TVavrinec/Jesper/MB12800/hardware/vysokonapetove_kondenzatory_JLCPCB.xlsx

keramika |  |  |  | elektrolit
oznaceni_JLCBPC | napeti | kapacita | proud | oznaceni_JLCBPC | napeti | kapacita
C13832 | 100V | 1.00µf |  | C311667 | 50V | 68.00µf
C307580 | 630V | 0.10µf | 50mA | C249459 | 100V | 10.00µf
C73745 | 250V | 0.10µf |  | C134777 | 100V | 47.00µf
C159756 | 200V | 0.10µf |  | C249458 | 100V | 10.00µf
 |  |  |  | C134747 | 100V | 10.00µf
 |  |  |  | C311614 | 63V | 22.00µf
 |  |  |  | C134831 | 80V | 47.00µf
 |  |  |  | C324061 | 100V | 22.00µf
 |  |  |  | C249468 | 63V | 100.00µf
 |  |  |  | C249491 | 100V | 22.00µf
 |  |  |  | C249576 | 100V | 10.00µf
 |  |  |  | C134817 | 100V | 22.00µf
 |  |  |  | C249899 | 100V | 33.00µf
 |  |  |  | C164068 | 100V | 47.00µf
 |  |  |  | C134748 | 100V | 10.00µf
