TVavrinec/Jesper/MB12800/hardware/kalkulacka_delice_ke_stabylizátoru.xlsx

 | r1 | r2
vstup | 127 | 100 | kΩ
vystup | korygovaný dělitel | 2.257124611
 | Vout | 2.742406402 | 2.798834517 | 2.855262633
