TVavrinec/Jesper/MB12800/hardware/seznam sistemu a vypočet napájecího proudu.xlsx

co | standard proud | maximální proud pro jeden kus [A] | kolikrát | maximum periperie | komplet standard | skok | napětí článku [V] | počet článku | napájecí napětí [V] | proud pro klasické srevo [A] | počet klasických serv | proud pro inteligentní srevo [A] | počet inteligentních serv | maximální výsledný proud pro celý systém [A] | standradní výsledný proud pro celý systém [A]
DRV8873 | 3 | 10 | 4 | 40 | 12 | 28 | 3.7 | 6 | 22.2 | 5 | 4 | 4 | 4 | 67.86974474 | 24.41126126
TCM2224 | 1.6 | 4 | 4 | 16 | 6.4 | 9.6
5V step down | 2.502502503 | 5.005005005 | 1 | 5.005005005 | 2.502502503 | 2.502502503
8V step down | 3.203203203 | 6.406406406 | 1 | 6.406406406 | 3.203203203 | 3.203203203
logika | 0.3055555556 | 0.4583333333 | 1 | 0.4583333333 | 0.3055555556 | 0.1527777778
 |  |  |  | 0 | 0 | 0
 |  |  |  | 0 | 0 | 0
 |  |  |  | 0 | 0 | 0
 |  |  |  | 0 | 0 | 0
 |  |  |  | 0 | 0 | 0
 |  |  |  | 0 | 0 | 0
 |  |  |  | 0 | 0 | 0
 |  |  |  | 0 | 0 | 0
 |  |  |  | 0 | 0 | 0
 |  |  |  | 0 | 0 | 0
 |  |  |  | 0 | 0 | 0
 |  |  |  | 0 | 0 | 0
 |  |  |  | 0 | 0 | 0
 |  |  |  | 0 | 0 | 0
 |  |  |  | 0 | 0 | 0
 |  |  |  | 0 | 0 | 0
 |  |  |  | 0 | 0 | 0
 |  |  |  | 0 | 0 | 0
 |  |  |  | 0 | 0 | 0
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
