TVavrinec/Jesper/RB3202S/hardware/V0.1/birokraccie/8067518513_awb51.pdf

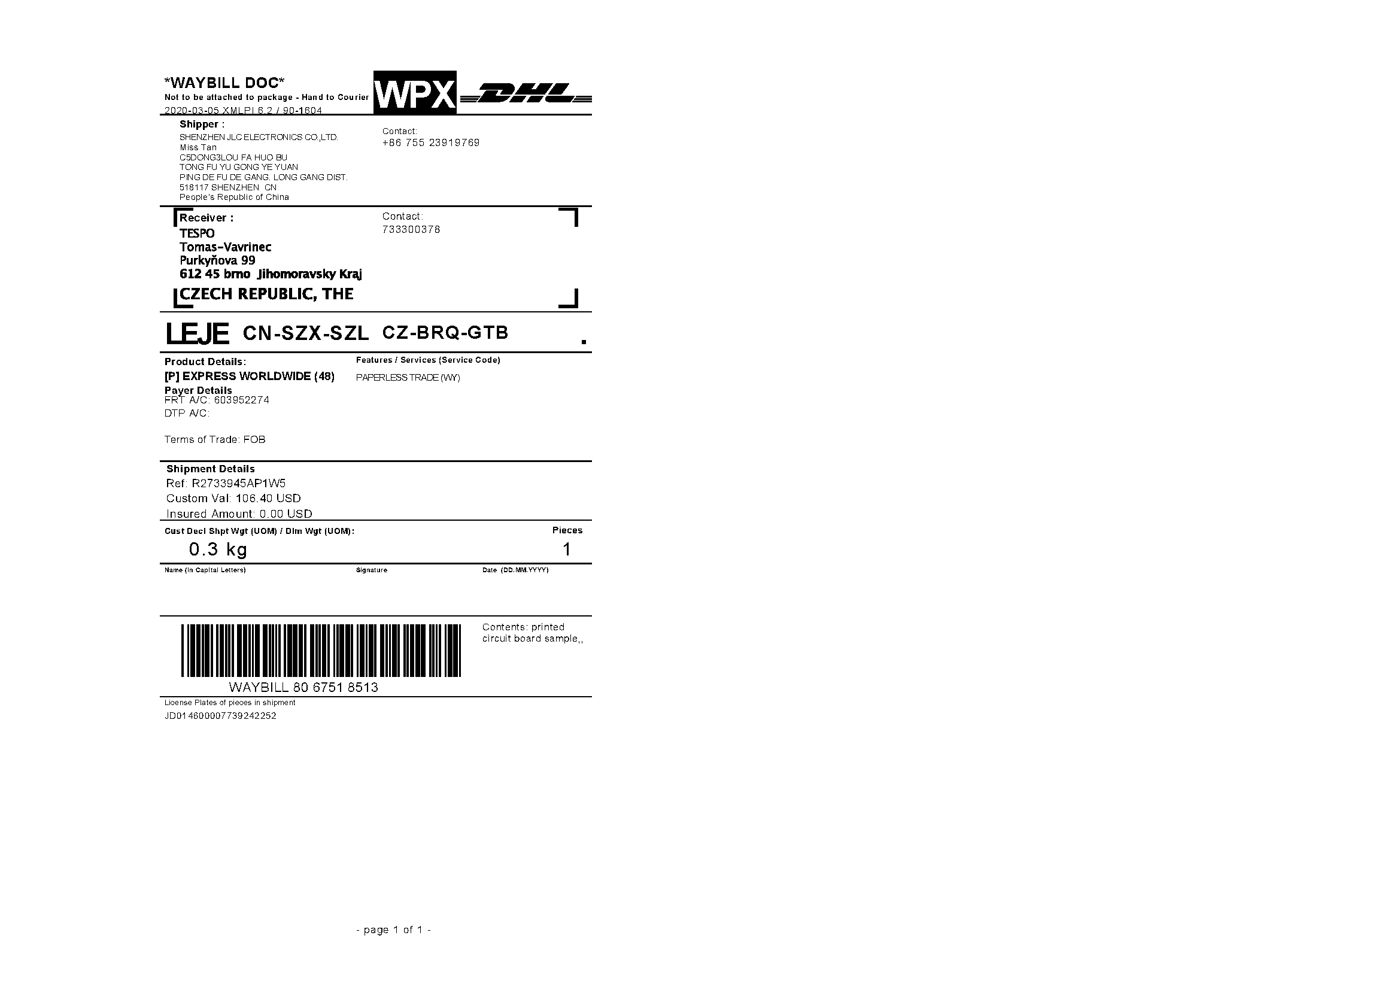
[picture p1: page 1]
