TVavrinec/Jesper/RB3202S/hardware/V0.1/birokraccie/8067518513_inv50.pdf

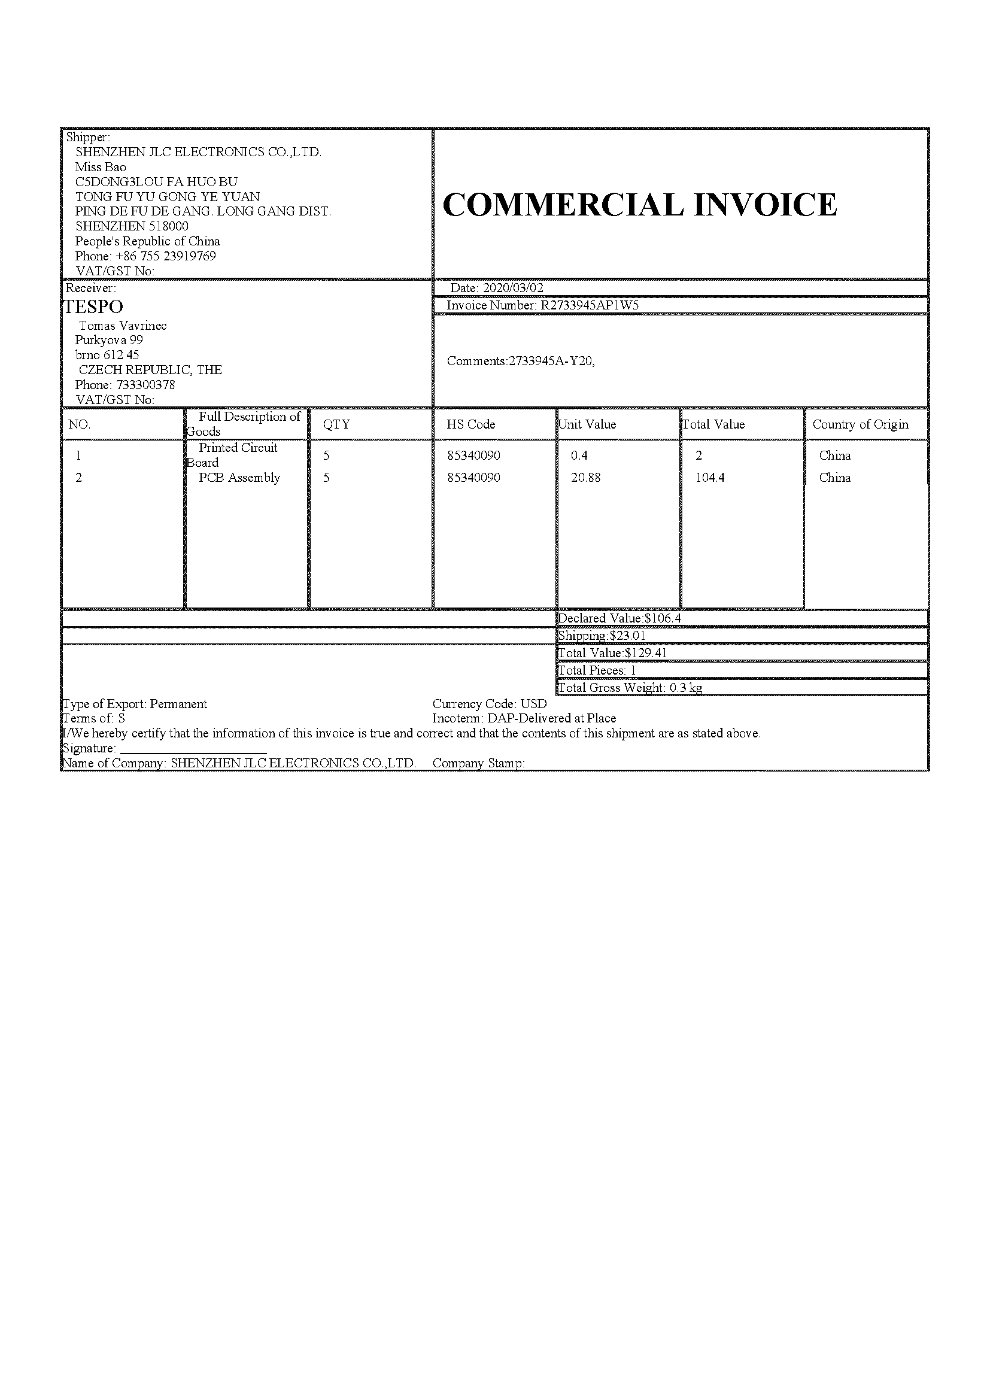
[picture p2: page 1]
