TVavrinec/Jesper/RB3202S/hardware/V0.2/123-removebg-preview.bmp

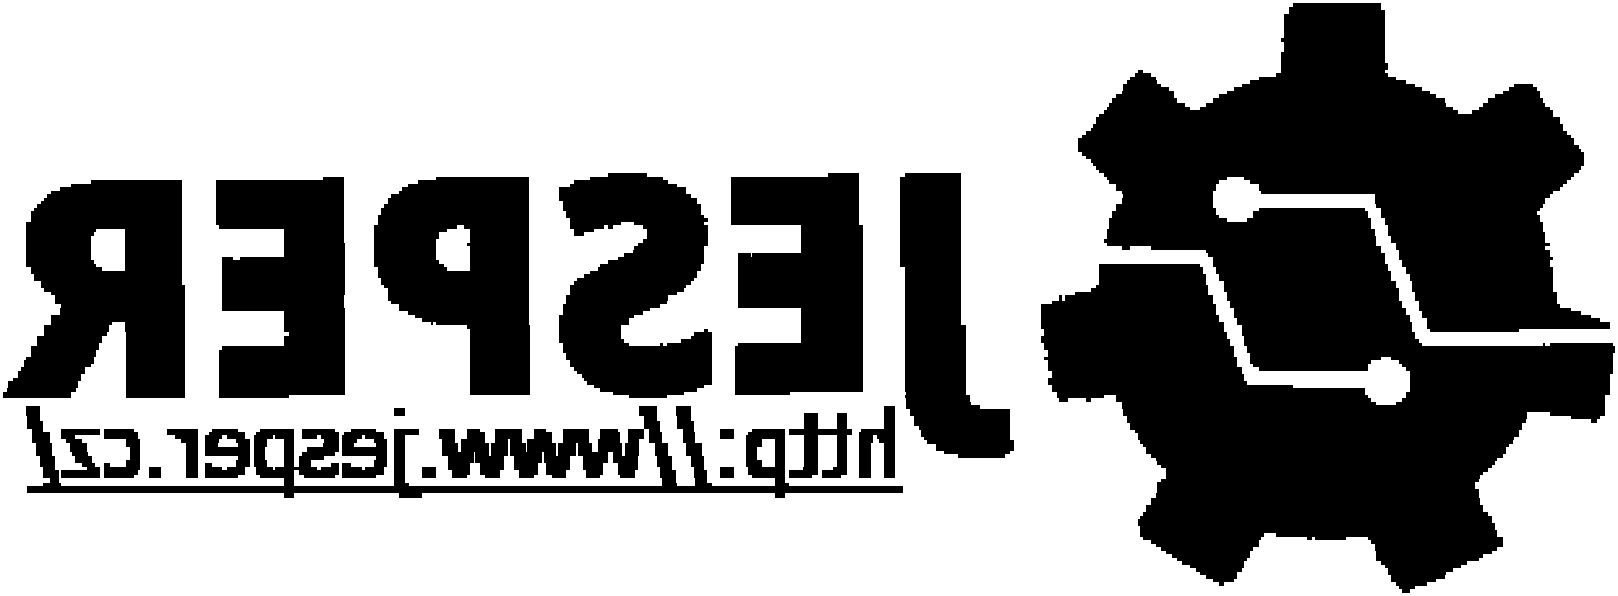
RB3202S/hardware/V0.2/123-removebg-preview.bmp
