TVavrinec/Jesper/RB3202S/navody/1/semafor na tlacitka.png

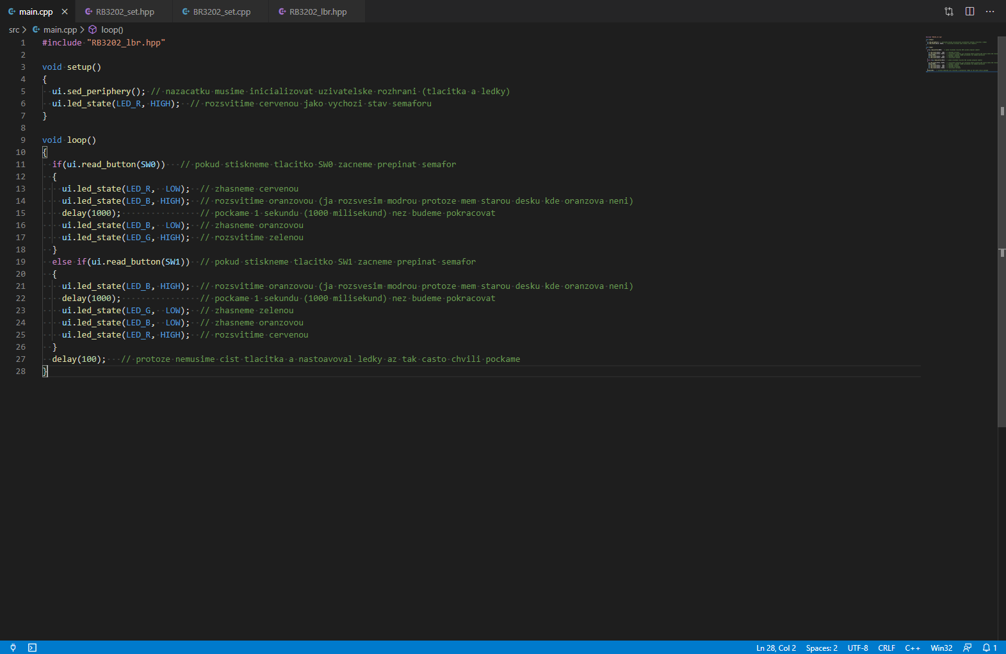
RB3202S/navody/1/semafor na tlacitka.png
