TVavrinec/Jesper/RB3202S/hardware/V0.2/gerber_file/BOM_RB3202S_V0.2.xlsx

Comment | Designator | Footprint | LCSC Part #（optional）
 | IC1, IC2 | SOT-233 | C134077
270uf | C6, C7 | SMD-ECAP-10x10 | C311624
100nf | C3, C4, C5, C8, C13, C14, C20, C21, C23 | 0402_C | C1525
10uf | C1, C2, C10, C11, C16, C17 | 1206_C | C89632 (https://lcsc.com/product-detail/Multilayer-Ceramic-Capacitors-MLCC-SMD-SMT_SAMSUNG_CL31B106KBHNNNE_10uF-106-10-50V_C89632.html/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)
10uf | C69, C70 | 0805_C | C15850
2.2uf | C9 | 0805_C | C49217 (https://lcsc.com/product-detail/Multilayer-Ceramic-Capacitors-MLCC-SMD-SMT_2-2uF-225-20-50V_C49217.html/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)
2.2nf | C12 | 0402_C | C1531
100nf | C18 | 1206_C | C24497
10nf | C15 | 0402_C | C15195
 | D1 | SMB,DO-214AA | C97318
 | D2 | SOD-323 | C8486 (https://lcsc.com/product-detail/Schottky-Barrier-Diodes-SBD_Changjiang-Electronics-Tech-CJ-1SS357_C8486.html/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)
 | LED0, LED4 | LED_0603 | C2286
 | LED2, LED3 | LED_0603 | C72043
 | LED1 | LED_0603 | C72038
 | SW0, SW1, SW2, SW3, ON, BOOT | SMD-SW-4_5.1x5.1x2.5 | C318887 (https://lcsc.com/product-detail/Tactile-Switches_XKB-Enterprise-TS-1187A-C-E-A_C318887.html/?href=jlc-SMT)
 | Q1, Q3 | DFN-8_EP_5.2x6.0x1.27P | C377869
 | Q2, Q4, Q5, Q6, Q7, Q10 | SOT-23-3 | C122850
 | U$9 | HTSSOP-16_EP_4.4x5.0x0.65P | C50506 (https://lcsc.com/product-detail/Motor-Drivers_TI_DRV8833PWP_DRV8833PWP_C50506.html/?href=jlc-SMT)
 | U1 | QFN-24_EP_4.0x4.0x0.5P | C24112
1M | R1, R4 | 0402_R | C26083
10k | R2, R6, R7, R8, R9, R10, R12, R20, R22, R23, R51 | 0402_R | C25744
100k | R3, R52 | 0402_R | C25741
100k | R5 | 0402_R | C25741 (https://lcsc.com/product-detail/Chip-Resistor-Surface-Mount_Uniroyal-Elec-0402WGF1003TCE_C25741.html/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)
30k | R11 | 0402_R | C105614 (https://lcsc.com/product-detail/High-Precision-Low-TCR-SMD-Resistors_Uniroyal-Elec-TC0225B3002TCE_C105614.html/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)
30k | R21 | 0402_R | C105614
30k | R49, R50 | 0402_R | C105614 (https://lcsc.com/product-detail/High-Precision-Low-TCR-SMD-Resistors_Uniroyal-Elec-TC0225B3002TCE_C105614.html/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)
120 | R48 | 0402_R | C25079 (https://lcsc.com/product-detail/Chip-Resistor-Surface-Mount_Uniroyal-Elec-0402WGF1200TCE_C25079.html/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)
220 | R13-19 | 0402_R | C25092
 | MAX1 | SOIC-8_3.9x4.9x1.27P | C23492 (https://lcsc.com/product-detail/RS-485-RS-422_MAXIM_MAX485EESA-T_MAX485EESA-T_C23492.html/?href=jlc-SMT)
