TVavrinec/Jesper/RB3202S/hardware/RB3202S.brd

## EAGLE design RB3202S/hardware/RB3202S.brd (2020-05-02)

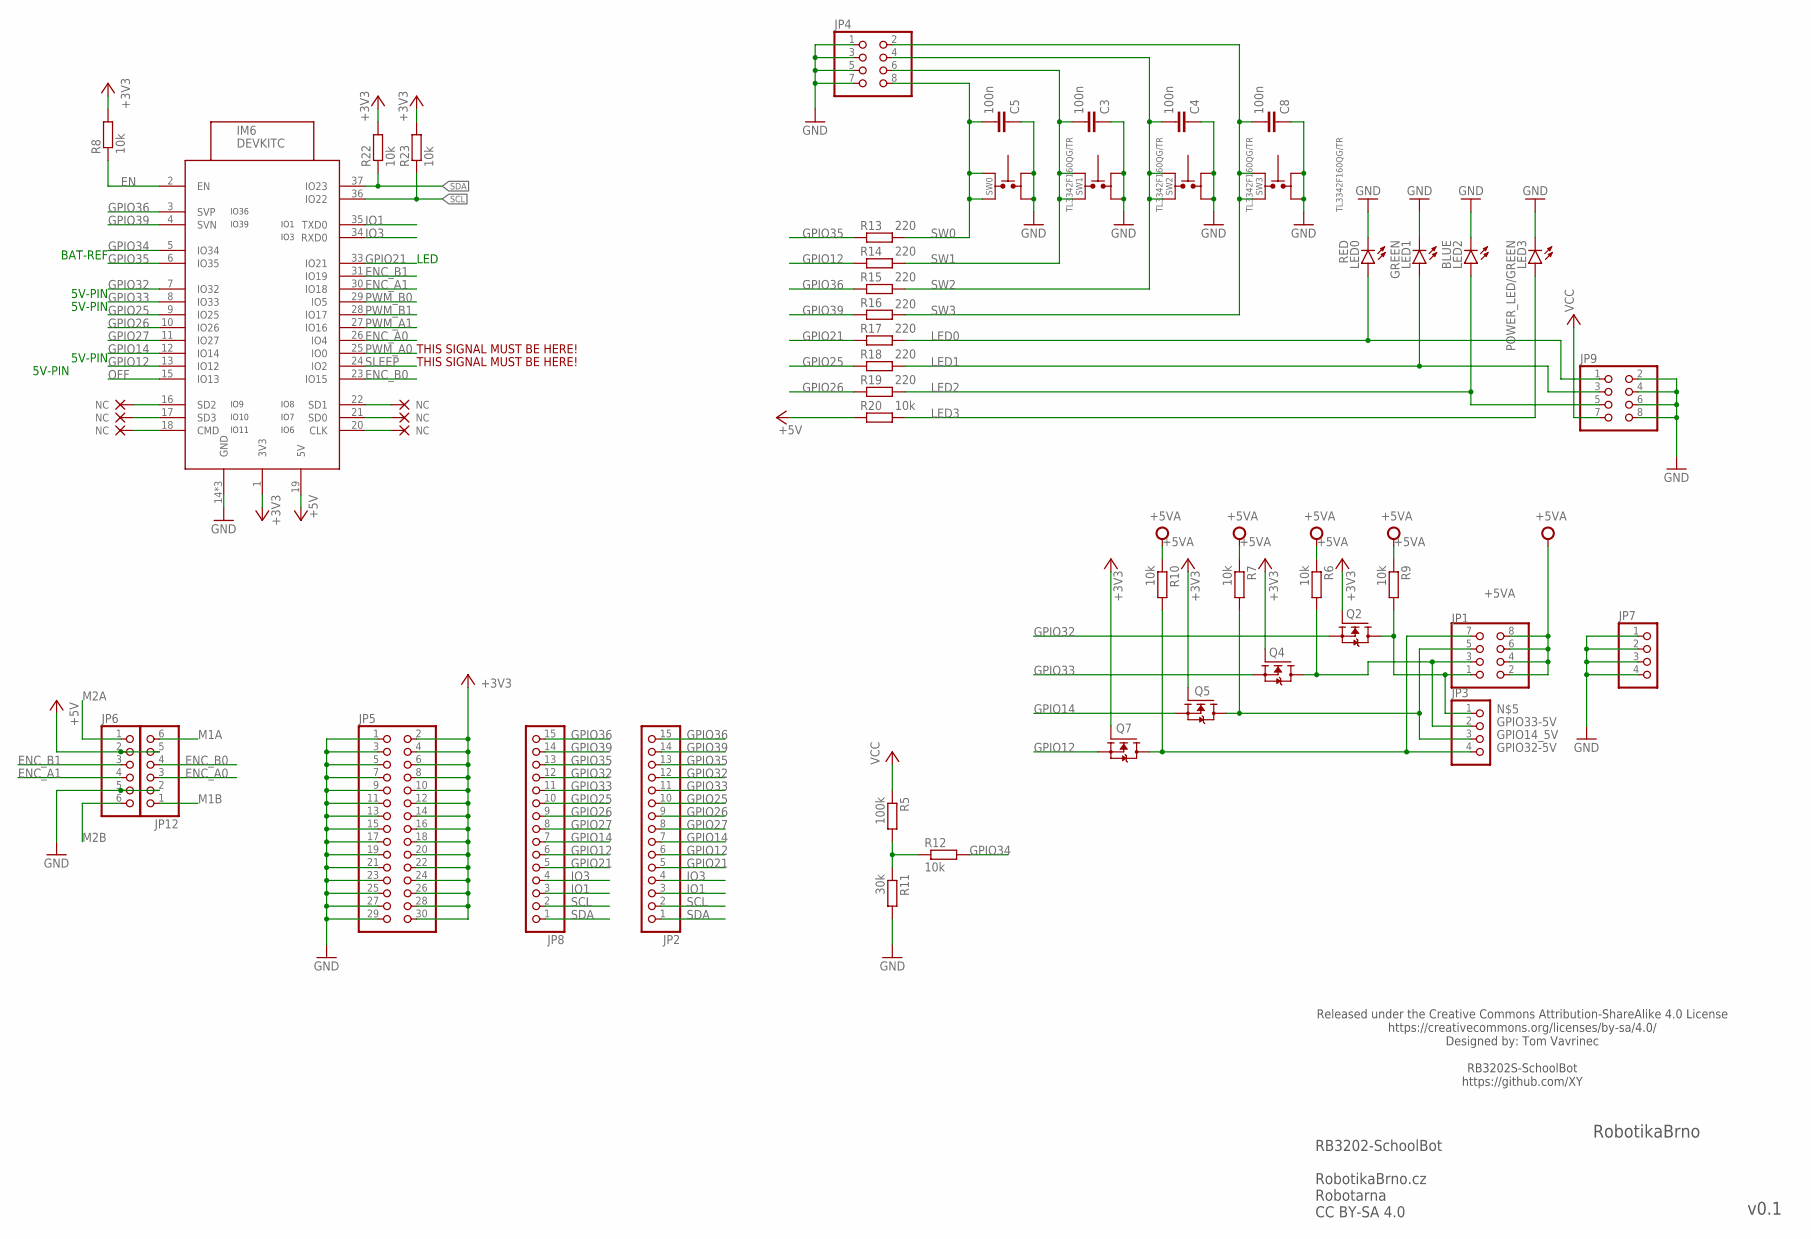
[picture p5: schematic RB3202S.sch, sheet 1]

Parts:
C3, C4, C5, C8: 100n; C0402
IM6: DEVKITC
JP1, JP4, JP9: PINHD-2X4; 2X04
JP2, JP8: PINHD-1X15; 1X15
JP3, JP7: PINHD-1X4; 1X04
JP5: PINHD-2X15; 2X15
JP6, JP12: PINHD-1X6; 1X06
LED0: RED; SML0603
LED1: GREEN; SML0603
LED2: BLUE; SML0603
LED3: POWER_LED/GREEN; SML0603
Q2, Q4, Q5, Q7: N-MOSFET-SOT23-GSD; SOT23
R5: 100k; R0402
R6, R7, R8, R9, R10, R12, R20, R22, R23: 10k; R0402
R11: 30k; R0402
R13, R14, R15, R16, R17, R18, R19: 220; R0402
SW0, SW1, SW2, SW3: TL3342F160QG/TR

Connections:
+3V3: IM6.1 (3V3), JP5.2, JP5.4, JP5.6, JP5.8, JP5.10, JP5.12, JP5.14, JP5.16, JP5.18, JP5.20, JP5.22, JP5.24, JP5.26, JP5.28, JP5.30, Q2.1 (G), Q4.1 (G), Q5.1 (G), Q7.1 (G), R8.2, R22.2, R23.2; also elsewhere on the board
+5V: IM6.19 (5V), JP6.2, JP12.5, R20.1; also elsewhere on the board
+5VA: JP1.2, JP1.4, JP1.6, JP1.8, R6.1, R7.1, R9.1, R10.1; also elsewhere on the board
EN: IM6.2 (EN), R8.1; also elsewhere on the board
ENC_A0: IM6.26 (IO4), JP12.3
ENC_A1: IM6.30 (IO18), JP6.4
ENC_B0: IM6.23 (IO15), JP12.4
ENC_B1: IM6.31 (IO19), JP6.3
GND: C3.1, C4.1, C5.1, C8.1, IM6.14 (GND), IM6.32 (GND), IM6.38 (GND), JP4.1, JP4.3, JP4.5, JP4.7, JP5.1, JP5.3, JP5.5, JP5.7, JP5.9, JP5.11, JP5.13, JP5.15, JP5.17, JP5.19, JP5.21, JP5.23, JP5.25, JP5.27, JP5.29, JP6.5, JP7.1, JP7.2, JP7.3, JP7.4, JP9.2, JP9.4, JP9.6, JP9.8, JP12.2, LED0.C, LED1.C, LED2.C, LED3.C, R11.2, SW0.1, SW0.2, SW1.1, SW1.2, SW2.1, SW2.2, SW3.1, SW3.2; also elsewhere on the board
GPIO12: IM6.13 (IO12), JP2.6, JP8.6, Q7.2 (S), R14.1
GPIO14: IM6.12 (IO14), JP2.7, JP8.7, Q5.2 (S)
GPIO14_5V: JP1.5, JP3.3, Q5.3 (D), R7.2
GPIO21: IM6.33 (IO21), JP2.5, JP8.5, R17.1; also elsewhere on the board
GPIO25: IM6.9 (IO25), JP2.10, JP8.10, R18.1
GPIO26: IM6.10 (IO26), JP2.9, JP8.9, R19.1
GPIO27: IM6.11 (IO27), JP2.8, JP8.8; also elsewhere on the board
GPIO32: IM6.7 (IO32), JP2.12, JP8.12, Q2.2 (S)
GPIO32-5V: JP1.7, JP3.4, Q7.3 (D), R10.2
GPIO33: IM6.8 (IO33), JP2.11, JP8.11, Q4.2 (S)
GPIO33-5V: JP1.3, JP3.2, Q4.3 (D), R6.2
GPIO34: IM6.5 (IO34), R12.2
GPIO35: IM6.6 (IO35), JP2.13, JP8.13, R13.1
GPIO36: IM6.3 (SVP), JP2.15, JP8.15, R15.1; also elsewhere on the board
GPIO39: IM6.4 (SVN), JP2.14, JP8.14, R16.1; also elsewhere on the board
IO1: IM6.35 (TXD0), JP2.3, JP8.3
IO3: IM6.34 (RXD0), JP2.4, JP8.4
IO9_NC: IM6.16 (SD2)
IO9_NC1: IM6.20 (CLK)
IO10_NC: IM6.17 (SD3)
IO10_NC1: IM6.21 (SD0)
IO11_NC: IM6.18 (CMD)
IO11_NC1: IM6.22 (SD1)
LED0: JP9.1, LED0.A, R17.2
LED1: JP9.3, LED1.A, R18.2
LED2: JP9.5, LED2.A, R19.2
LED3: LED3.A, R20.2
M1A: JP12.6; also elsewhere on the board
M1B: JP12.1; also elsewhere on the board
M2A: JP6.1; also elsewhere on the board
M2B: JP6.6; also elsewhere on the board
unnamed: R5.2, R11.1, R12.1
unnamed: JP1.1, JP3.1, Q2.3 (D), R9.2
OFF: IM6.15 (IO13); also elsewhere on the board
PWM_A0: IM6.25 (IO0); also elsewhere on the board
PWM_A1: IM6.27 (IO16); also elsewhere on the board
PWM_B0: IM6.29 (IO5); also elsewhere on the board
PWM_B1: IM6.28 (IO17); also elsewhere on the board
SCL: IM6.36 (IO22), JP2.2, JP8.2, R23.1; also elsewhere on the board
SDA: IM6.37 (IO23), JP2.1, JP8.1, R22.1; also elsewhere on the board
SLEEP: IM6.24 (IO2); also elsewhere on the board
SW0: C5.2, JP4.8, R13.2, SW0.3, SW0.4
SW1: C3.2, JP4.6, R14.2, SW1.3, SW1.4
SW2: C4.2, JP4.4, R15.2, SW2.3, SW2.4
SW3: C8.2, JP4.2, R16.2, SW3.3, SW3.4
VCC: JP9.7, R5.1; also elsewhere on the board

Notes on the sheet:
RB3202-SchoolBot RobotikaBrno.cz Robotarna CC BY-SA 4.0
RobotikaBrno
v0.1
Released under the Creative Commons Attribution-ShareAlike 4.0 License https://creativecommons.org/licenses/by-sa/4.0/ Designed by: Tom Vavrinec RB3202S-SchoolBot https://github.com/XY
THIS SIGNAL MUST BE HERE!
LED
5V-PIN
BAT-REF

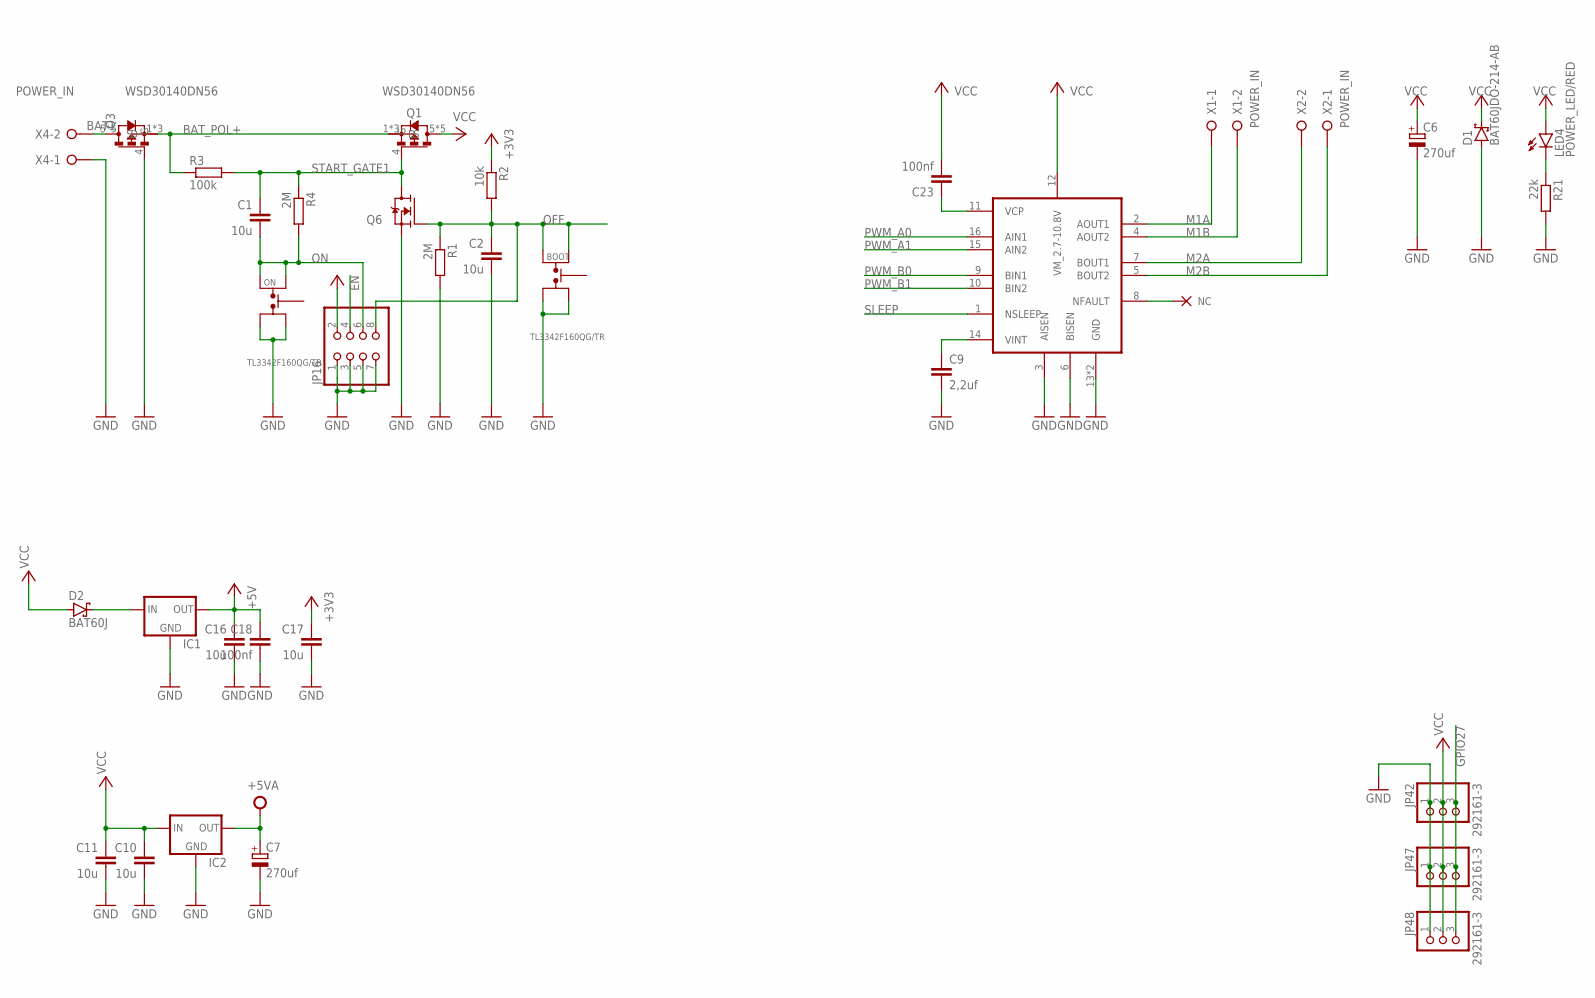
[picture p6: schematic RB3202S.sch, sheet 2]

Parts:
BOOT: TL3342F160QG/TR
C1, C2, C10, C11, C16, C17: 10u; C1206
C6, C7: 270uf; 140CLH-1010
C9: 2,2uf; C0805
C18: 100nf; C1206
C23: 100nf; C0402
D1: BAT60JDO-214-AB; DO214BA
D2: BAT60J; SOD323_ST
IC1, IC2: LM1117; SOT223
JP16: PINHD-2X4; 2X04
JP42, JP47, JP48: 292161-3
LED4: POWER_LED/RED; SML0603
ON: TL3342F160QG/TR
Q1, Q3: WSD30140DN56; DFN-8_EP_5.2X6.0X1.27P
Q6: N-MOSFET-SOT23-GSD; SOT23
R1, R4: 2M; R0402
R2: 10k; R0402
R3: 100k; R0402
R21: 22k; R0402
U$9: DRV8833CPWPR; SOP65P640X120-17N
X1, X2, X4: POWER_IN; W237-132

Connections:
+3V3: C17.1, R2.1; also elsewhere on the board
+5V: C16.1, C18.1, IC1.2 (OUT), IC1.4 (OUT), JP16.2; also elsewhere on the board
+5VA: C7.+, IC2.2 (OUT), IC2.4 (OUT); also elsewhere on the board
BAT1: Q3.5 (D), Q3.6 (D), Q3.7 (D), Q3.8 (D), Q3.9 (D), X4.2
BAT_POL+: Q1.1 (S), Q1.2 (S), Q1.3 (S), Q3.1 (S), Q3.2 (S), Q3.3 (S), R3.1
EN: JP16.4; also elsewhere on the board
GND: BOOT.1, BOOT.2, C2.2, C6.-, C7.-, C9.2, C10.2, C11.2, C16.2, C17.2, C18.2, D1.A, IC1.1 (GND), IC2.1 (GND), JP16.1, JP16.3, JP16.5, JP16.7, JP42.1, JP47.1, JP48.1, ON.1, ON.2, Q3.4 (G), Q6.2 (S), R1.2, R21.2, U$9.3 (AISEN), U$9.6 (BISEN), U$9.13 (GND), U$9.17 (GND), X4.1; also elsewhere on the board
GPIO27: JP42.3, JP47.3, JP48.3; also elsewhere on the board
IO9_NC2: U$9.8 (NFAULT)
M1A: U$9.2 (AOUT1), X1.1; also elsewhere on the board
M1B: U$9.4 (AOUT2), X1.2; also elsewhere on the board
M2A: U$9.7 (BOUT1), X2.2; also elsewhere on the board
M2B: U$9.5 (BOUT2), X2.1; also elsewhere on the board
unnamed: LED4.C, R21.1
unnamed: D2.C, IC1.3 (IN)
unnamed: C9.1, U$9.14 (VINT)
unnamed: C23.1, U$9.11 (VCP)
OFF: BOOT.3, BOOT.4, C2.1, JP16.8, Q6.1 (G), R1.1, R2.2; also elsewhere on the board
ON: C1.2, JP16.6, ON.3, ON.4, R4.2
PWM_A0: U$9.16 (AIN1); also elsewhere on the board
PWM_A1: U$9.15 (AIN2); also elsewhere on the board
PWM_B0: U$9.9 (BIN1); also elsewhere on the board
PWM_B1: U$9.10 (BIN2); also elsewhere on the board
SLEEP: U$9.1 (NSLEEP); also elsewhere on the board
START_GATE1: C1.1, Q1.4 (G), Q6.3 (D), R3.2, R4.1
VCC: C6.+, C10.1, C11.1, C23.2, D1.C, D2.A, IC2.3 (IN), JP42.2, JP47.2, JP48.2, LED4.A, Q1.5 (D), Q1.6 (D), Q1.7 (D), Q1.8 (D), Q1.9 (D), U$9.12 (VM_2.7-10.8V); also elsewhere on the board

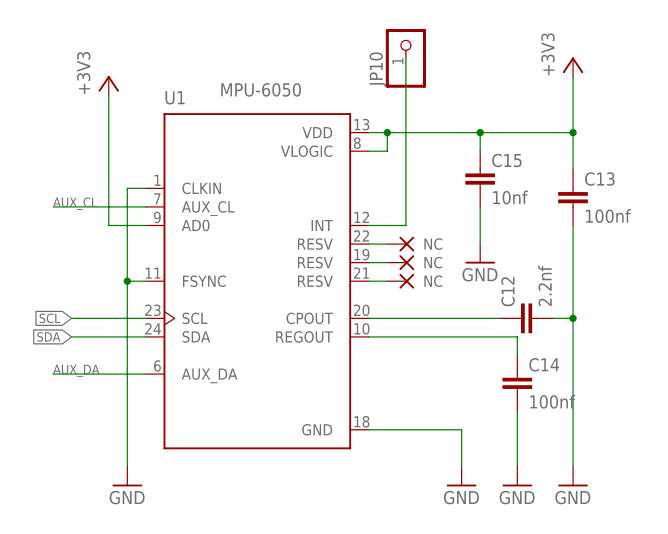
[picture p7: schematic RB3202S.sch, sheet 3]

Parts:
C12: 2.2nf; C0402
C13: 100nf; C0402
C14: 100nf; C0402P
C15: 10nf; C0402
JP10: PINHD-1X1; 1X01
U1: MPU-6050; QFN50P400X400X95-24N

Connections:
+3V3: C13.1, C15.1, U1.8 (VLOGIC), U1.9 (AD0), U1.13 (VDD); also elsewhere on the board
AUX_CL: U1.7 (AUX_CL)
AUX_DA: U1.6 (AUX_DA)
GND: C12.2, C13.2, C14.2, C15.2, U1.1 (CLKIN), U1.11 (FSYNC), U1.18 (GND); also elsewhere on the board
INT_MPU5060: JP10.1, U1.12 (INT)
IO9_NC4: U1.19 (RESV)
IO9_NC5: U1.21 (RESV)
IO10_NC4: U1.22 (RESV)
unnamed: C12.1, U1.20 (CPOUT)
unnamed: C14.1, U1.10 (REGOUT)
SCL: U1.23 (SCL); also elsewhere on the board
SDA: U1.24 (SDA); also elsewhere on the board

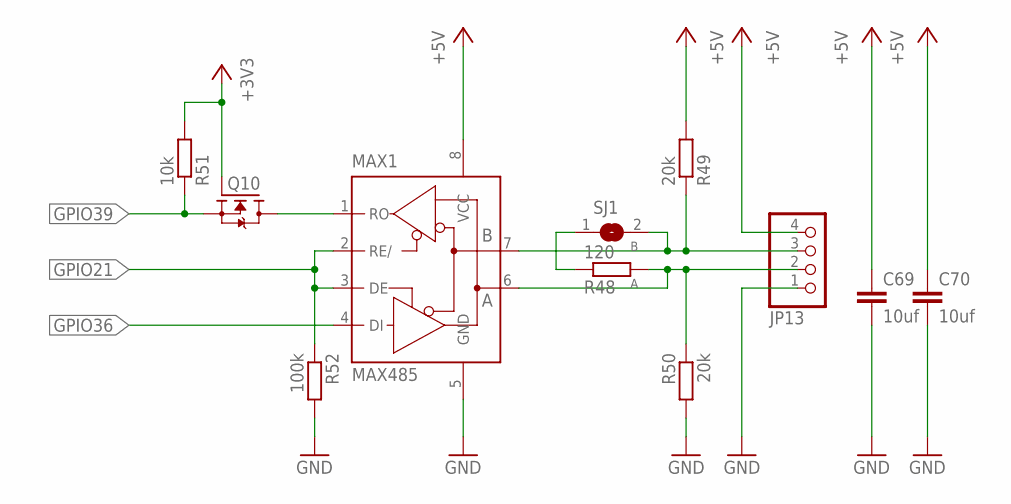
[picture p8: schematic RB3202S.sch, sheet 4]

Parts:
C69, C70: 10uf; C0805
JP13: PINHD-1X4; 1X04
MAX1: MAX485; SO08
Q10: N-MOSFET-SOT23-GSD; SOT23
R48: 120; R0402
R49, R50: 20k; R0402
R51: 10k; R0402
R52: 100k; R0402
SJ1: SJ

Connections:
+3V3: Q10.1 (G), R51.2; also elsewhere on the board
+5V: C69.1, C70.1, JP13.4, MAX1.8 (VCC), R49.2; also elsewhere on the board
A: JP13.2, MAX1.6 (A), R48.2, R50.1
B: JP13.3, MAX1.7 (B), R49.1, SJ1.2
GND: C69.2, C70.2, JP13.1, MAX1.5 (GND), R50.2, R52.2; also elsewhere on the board
GPIO21: MAX1.2 (RE/), MAX1.3 (DE), R52.1; also elsewhere on the board
GPIO36: MAX1.4 (DI); also elsewhere on the board
GPIO39: Q10.2 (S), R51.1; also elsewhere on the board
unnamed: R48.1, SJ1.1
RX-485-5V: MAX1.1 (RO), Q10.3 (D)

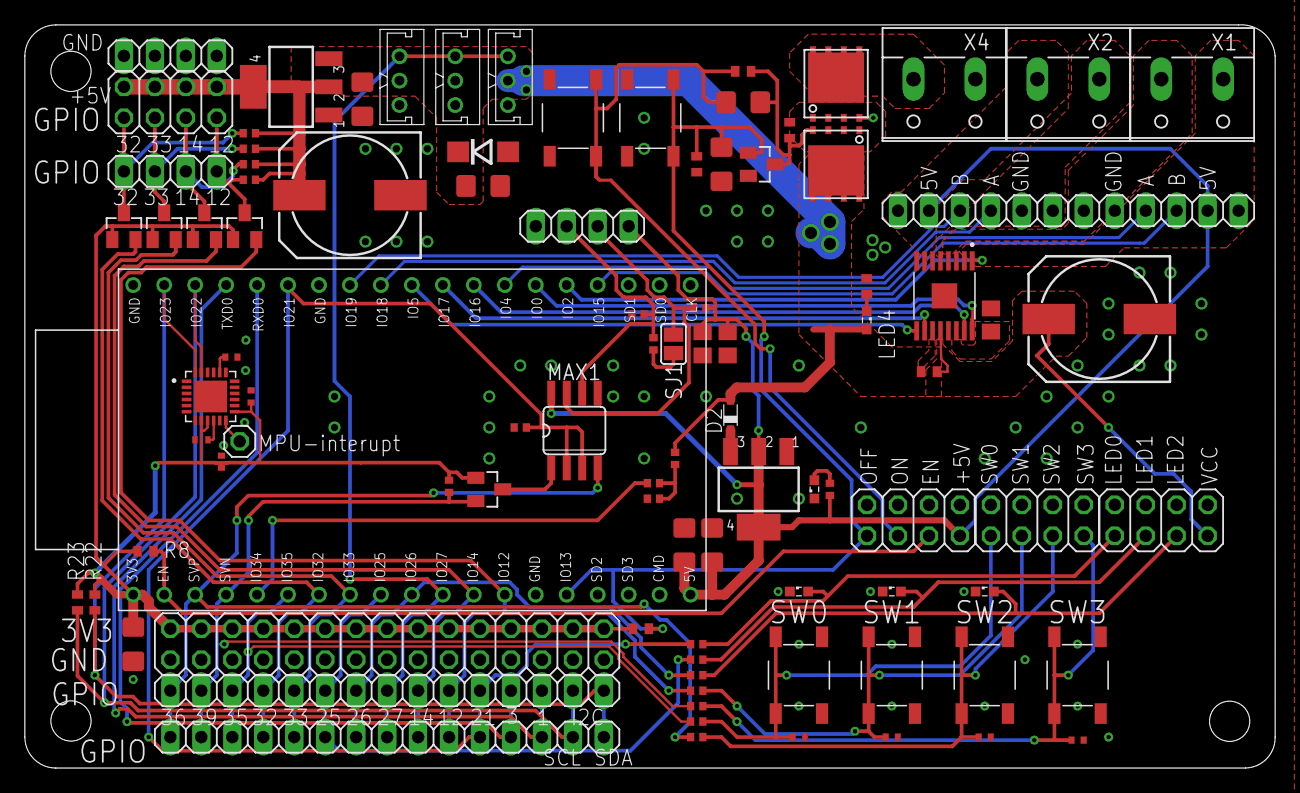
[picture p9: board RB3202S.brd from above]

Board: 2 copper layers, 102.6 x 61.0 mm, 96 parts (0 on the bottom side), 64 nets.
