TVavrinec/Jesper/UI01/untitled.brd

## EAGLE design UI01/untitled.brd (2020-02-24)

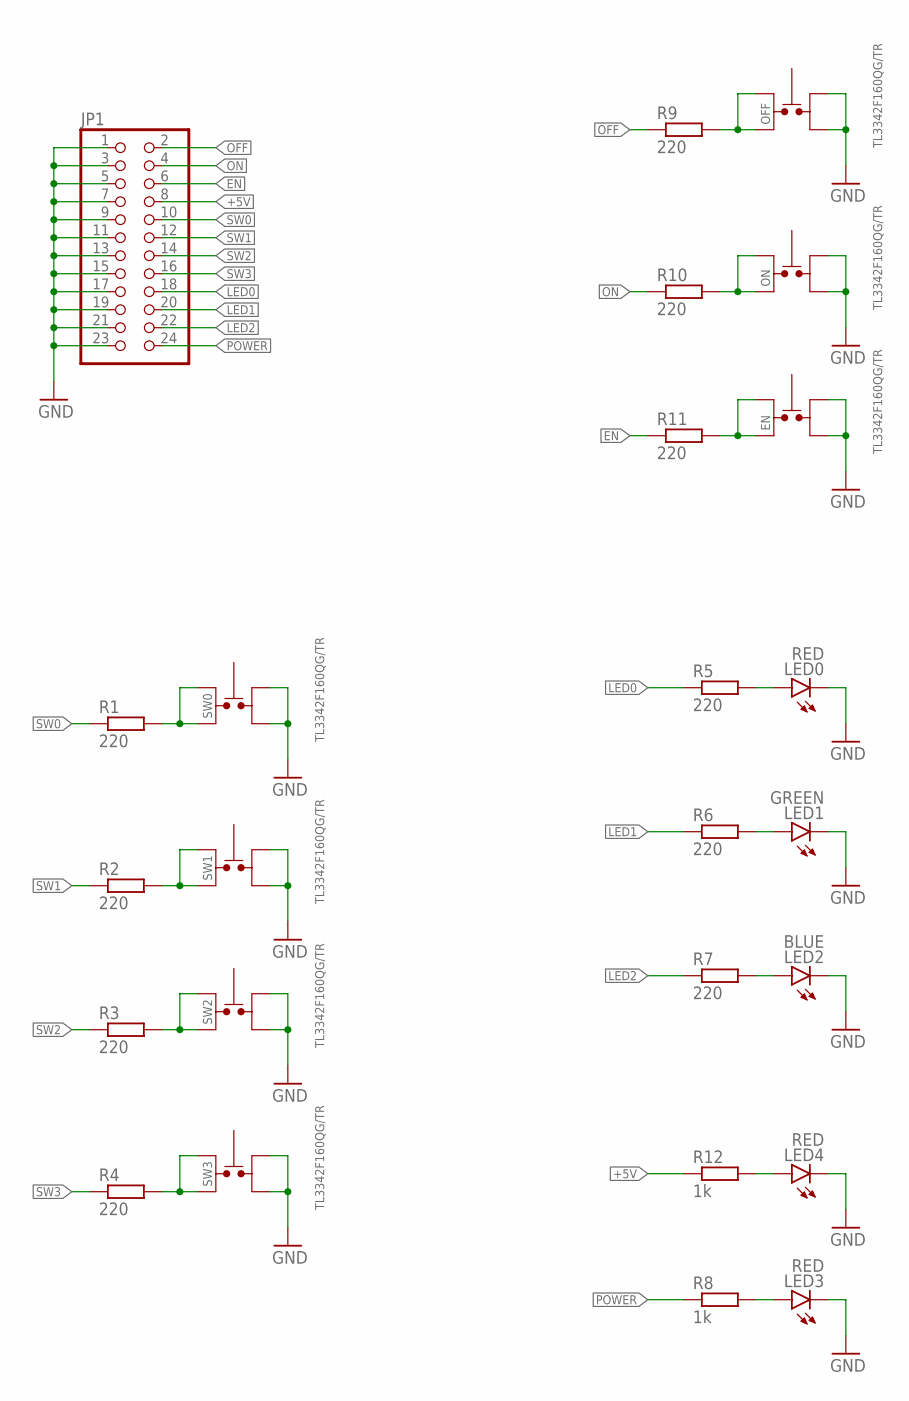
[picture p10: schematic untitled.sch]

Parts:
EN: TL3342F160QG/TR
JP1: PINHD-2X12; 2X12
LED0, LED3, LED4: RED; SML0603
LED1: GREEN; SML0603
LED2: BLUE; SML0603
OFF: TL3342F160QG/TR
ON: TL3342F160QG/TR
R1, R2, R3, R4, R5, R6, R7, R9, R10, R11: 220; R0402
R8, R12: 1k; R0402
SW0, SW1, SW2, SW3: TL3342F160QG/TR

Connections:
+5V: JP1.8, R12.1
EN: JP1.6, R11.1
GND: EN.1, EN.2, JP1.1, JP1.3, JP1.5, JP1.7, JP1.9, JP1.11, JP1.13, JP1.15, JP1.17, JP1.19, JP1.21, JP1.23, LED0.C, LED1.C, LED2.C, LED3.C, LED4.C, OFF.1, OFF.2, ON.1, ON.2, SW0.1, SW0.2, SW1.1, SW1.2, SW2.1, SW2.2, SW3.1, SW3.2
LED0: JP1.18, R5.1
LED1: JP1.20, R6.1
LED2: JP1.22, R7.1
unnamed: R1.2, SW0.3, SW0.4
unnamed: R2.2, SW1.3, SW1.4
unnamed: R3.2, SW2.3, SW2.4
unnamed: R4.2, SW3.3, SW3.4
unnamed: LED0.A, R5.2
unnamed: LED1.A, R6.2
unnamed: LED2.A, R7.2
unnamed: LED3.A, R8.2
unnamed: OFF.3, OFF.4, R9.2
unnamed: ON.3, ON.4, R10.2
unnamed: EN.3, EN.4, R11.2
unnamed: LED4.A, R12.2
OFF: JP1.2, R9.1
ON: JP1.4, R10.1
POWER: JP1.24, R8.1
SW0: JP1.10, R1.1
SW1: JP1.12, R2.1
SW2: JP1.14, R3.1
SW3: JP1.16, R4.1

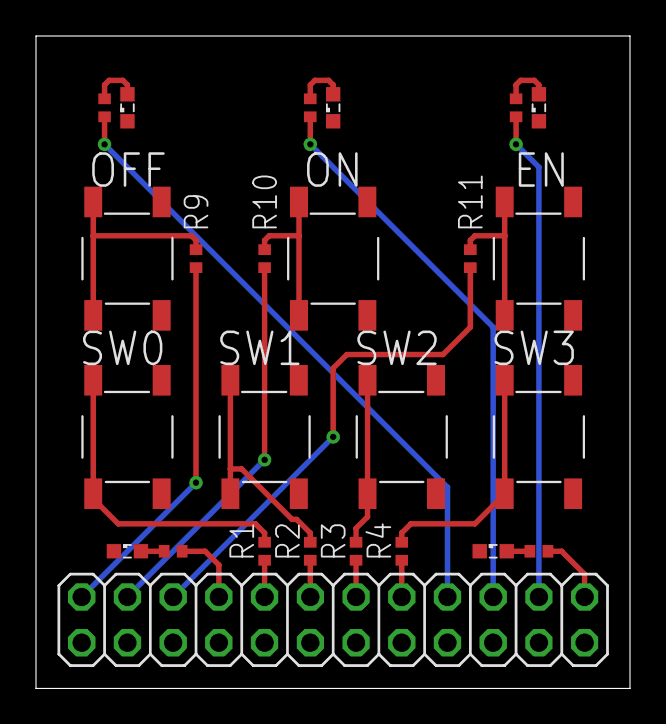
[picture p11: board untitled.brd from above]

Board: 2 copper layers, 33.0 x 36.2 mm, 25 parts (0 on the bottom side), 25 nets.
