TVavrinec/Jesper/RB3202S/program_lbr/src/RB3202_encoder.cpp

#include <stdio.h>
#include "freertos/FreeRTOS.h"
#include "freertos/portmacro.h"
#include "freertos/task.h"
#include "freertos/queue.h"
#include "driver/periph_ctrl.h"
#include "driver/gpio.h"
#include "driver/pcnt.h"
#include "esp_attr.h"
#include "esp_log.h"
#include "soc/gpio_sig_map.h"
//#include "esp32-hal-adc.h"
#include "esp_system.h"
#include "RB3202_encoder.hpp"

uint64_t RB3202_encoder::gpioInputPinSel = 1;
uint8_t RB3202_encoder::nextCounterIndex = 0;

void IRAM_ATTR RB3202_encoder::gpio_isr_handler(void* arg) 
{
    //Handle edge interrupt time for frequency calculation
    int64_t currentTime = esp_timer_get_time();
    struct CounterTimeData * aCounterTimeData = (struct CounterTimeData *)arg;
    if(currentTime > aCounterTimeData->counterPrevTime + aCounterTimeData->debounceUs) 
    {
        aCounterTimeData->counterTimeDiff = currentTime - aCounterTimeData->counterPrevTime;
        if(gpio_get_level(static_cast<gpio_num_t>(pcntPins[2*(aCounterTimeData->aCounterIndex) + 1])))
            aCounterTimeData->counterTimeDiff = -aCounterTimeData->counterTimeDiff;
        aCounterTimeData->counterPrevTime = currentTime;
    }
    //TODO - Handle possible PCNT overflow interrupt...
}

RB3202_encoder::RB3202_encoder(uint8_t aGpioA, uint8_t aGpioB) 
{
    
    counterIndex = nextCounterIndex++;
    if(counterIndex > 7) {  //Out of PCNT units
        return;
    }
    gpioA = aGpioA;
    gpioB = aGpioB;
    for(uint8_t i = 0; i < 16; ++i) 
    {
        if(gpioA == pcntPins[i] )
            break;
        if(i == 15) 
        {   //Not a PCNT enabled pin selected first
            return;
        }
    }
}

void RB3202_encoder::init() {
    pcnt_ctrl_mode_t lctrl_mode = reverse ? PCNT_MODE_REVERSE : PCNT_MODE_KEEP;
    pcnt_ctrl_mode_t hctrl_mode = reverse ? PCNT_MODE_KEEP : PCNT_MODE_REVERSE;
    pcnt_count_mode_t pos_mode = risingSensitive ? PCNT_COUNT_INC : PCNT_COUNT_DIS;
    pcnt_count_mode_t neg_mode = fallingSensitive ? PCNT_COUNT_DEC : PCNT_COUNT_DIS;

    //Initialize PCNT functions
    pcnt_config_t pcnt_config = 
    {
        // Set PCNT input signal and control GPIOs
        gpioA,   //pulse_gpio_num
        gpioB,    //ctrl_gpio_num
        // What to do when control input is low or high?
        lctrl_mode,   //lctrl_mode  // Keep the primary counter mode if high
        hctrl_mode,  //hctrl_mode   // Reverse counting direction if low
        // What to do on the positive / negative edge of pulse input?
        pos_mode, //pos_mode   // Count up on the positive edge
        neg_mode, //neg_mode   // Keep the counter value on the negative edge
        // Set the maximum and minimum limit values to watch
        PCNT_H_LIM_VAL, //counter_h_lim
        PCNT_L_LIM_VAL, //counter_l_lim
        pcnt_unit_t(counterIndex),   //unit
        PCNT_CHANNEL_0, //channel
    };
    pcnt_unit_config(&pcnt_config); //Initialize PCNT units

    /* Configure and enable the input filter */
    pcnt_set_filter_value(pcnt_unit_t(counterIndex), 255);
    pcnt_filter_enable(pcnt_unit_t(counterIndex));

    /* Set threshold 0 and 1 values and enable events to watch */
    pcnt_set_event_value(pcnt_unit_t(counterIndex), PCNT_EVT_THRES_1, PCNT_THRESH1_VAL);
    pcnt_event_enable(pcnt_unit_t(counterIndex), PCNT_EVT_THRES_1);
    pcnt_set_event_value(pcnt_unit_t(counterIndex), PCNT_EVT_THRES_0, PCNT_THRESH0_VAL);
    pcnt_event_enable(pcnt_unit_t(counterIndex), PCNT_EVT_THRES_0);
    /* Enable events on zero, maximum and minimum limit values */
    pcnt_event_enable(pcnt_unit_t(counterIndex), PCNT_EVT_ZERO);
    pcnt_event_enable(pcnt_unit_t(counterIndex), PCNT_EVT_H_LIM);
    pcnt_event_enable(pcnt_unit_t(counterIndex), PCNT_EVT_L_LIM);

    /* Initialize PCNT's counter */
    pcnt_counter_pause(pcnt_unit_t(counterIndex));
    pcnt_counter_clear(pcnt_unit_t(counterIndex));

    /* Everything is set up, now go to counting */
    pcnt_counter_resume(pcnt_unit_t(counterIndex));

    gpioInputPinSel = gpioInputPinSel | (1ULL<<gpioA);

    //Initialize interrupts
    if(enableInterrupts) 
    {
        counterTimeData.counterTimeDiff = 0;
        counterTimeData.counterPrevTime = 0;
        counterTimeData.aCounterIndex = counterIndex;
        counterTimeData.debounceUs = debounceUs;

        gpio_config_t io_conf;
        //disable interrupt
        io_conf.intr_type = static_cast<gpio_int_type_t>(GPIO_PIN_INTR_DISABLE);
        //interrupt of rising edge
        io_conf.intr_type = GPIO_INTR_POSEDGE;  //ANYEDGE gives oscillating time differences in engine rotor half turns
        //bit mask of the pins
        io_conf.pin_bit_mask = gpioInputPinSel;
        //set as input mode
        io_conf.mode = GPIO_MODE_INPUT;
        //enable pull-up mode - unconnected GPIOs tend to invoke interrupts unintentionally
        io_conf.pull_up_en = static_cast<gpio_pullup_t>(1);
        gpio_config(&io_conf);

        //install gpio isr service
        gpio_install_isr_service(ESP_INTR_FLAG_DEFAULT);
        //hook isr handler for specific gpio pins
        gpio_isr_handler_add(static_cast<gpio_num_t>(gpioA), gpio_isr_handler, (void*)&counterTimeData);   //interrupts use counter index 0-7 instead of invoking GPIO pin number
    }
}

int32_t RB3202_encoder::getCount() 

{
    pcnt_get_counter_value(pcnt_unit_t(counterIndex), &PCNT_internal_count);
    pcnt_counter_clear(pcnt_unit_t(counterIndex));
    PCNT_count += PCNT_internal_count;
    return PCNT_count;
}

int16_t RB3202_encoder::getDiff() 
{
    pcnt_get_counter_value(pcnt_unit_t(counterIndex), &PCNT_internal_count);
    pcnt_counter_clear(pcnt_unit_t(counterIndex));
    PCNT_count += PCNT_internal_count;
    return PCNT_internal_count;
}

float RB3202_encoder::getFrequency() 
{
    if(esp_timer_get_time() > (counterTimeData.counterPrevTime + maxPeriodUs))
        frequency = 0.0;
    else if(abs(counterTimeData.counterTimeDiff) < minPeriodUs){
        frequency = 0.0;
        counterTimeData.counterTimeDiff = 0;
    }
    else
        frequency = 1000000.0 / counterTimeData.counterTimeDiff;
    return frequency; 
}

void RB3202_encoder::clearCount() 
{
    PCNT_count = 0;
}
