TVavrinec/Jesper/RB3202S/program_lbr/src/RB3202_driver.hpp

#pragma once

#include "RB3202_DRV8833.hpp"

class RB3202_driver: public RB3202_DRV8833
{
private:
protected:
public:
    RB3202_driver();

    void motorStartWorking();
    void stop();
    void setMotor();
    void power(float power_0, float power_1);
    void soloPower(float power, bool motor);
    void stop(bool motor);

    ~RB3202_driver();
};
