TVavrinec/Jesper/RB3202S/program_lbr/src/RB3202_lbr.hpp

#pragma once

//#include <Arduino.h>
#include <math.h>

#include "RB3202_pinout.hpp"
#include "RB3202_user_interface.hpp"
//#include "RB3202_driver.hpp"
//#include "RB3202_encoder.hpp"
//#include "RB3202_PID.hpp"
//#include "RB3202_stepdriver.hpp"

rb_user_interface ui;
