TVavrinec/Jesper/(commit log)

2020-03-10 BlackBox standard
    [BOM_RB3202S.xlsx, SchoolBoard.brd, SchoolBoard.sch, SchoolBoard0.brd, untitled.sch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]
2020-03-14 oprava ledek
2020-05-02 zarazeni verze do jmena
    [BOM_RB3202S.xlsx, BOM_RB3202S_0.1.xlsx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]
2020-05-02 cisteni + gitignore
    [SchoolBoard.brd]
2020-05-02 aktualni nazvy
    [RB3202S_V0.2.brd, RB3202S_V0.2.sch, SchoolBoard.sch]
2020-05-02 vyrova
    vytvoreni slozky pro verzi 0.2
    [BOM_RB3202S_V0.2.xlsx, RB3202S_V0.2.brd, RB3202S_V0.2.sch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]
2020-05-02 aktualni eagle soubory
    pro dalsi upravu
    [RB3202S.brd, RB3202S.sch]
